adafruit/Adafruit-24LC32-PCB/Adafruit 24LC32 I2C EEPROM.brd

## EAGLE design Adafruit 24LC32 I2C EEPROM.brd (2021-08-11)

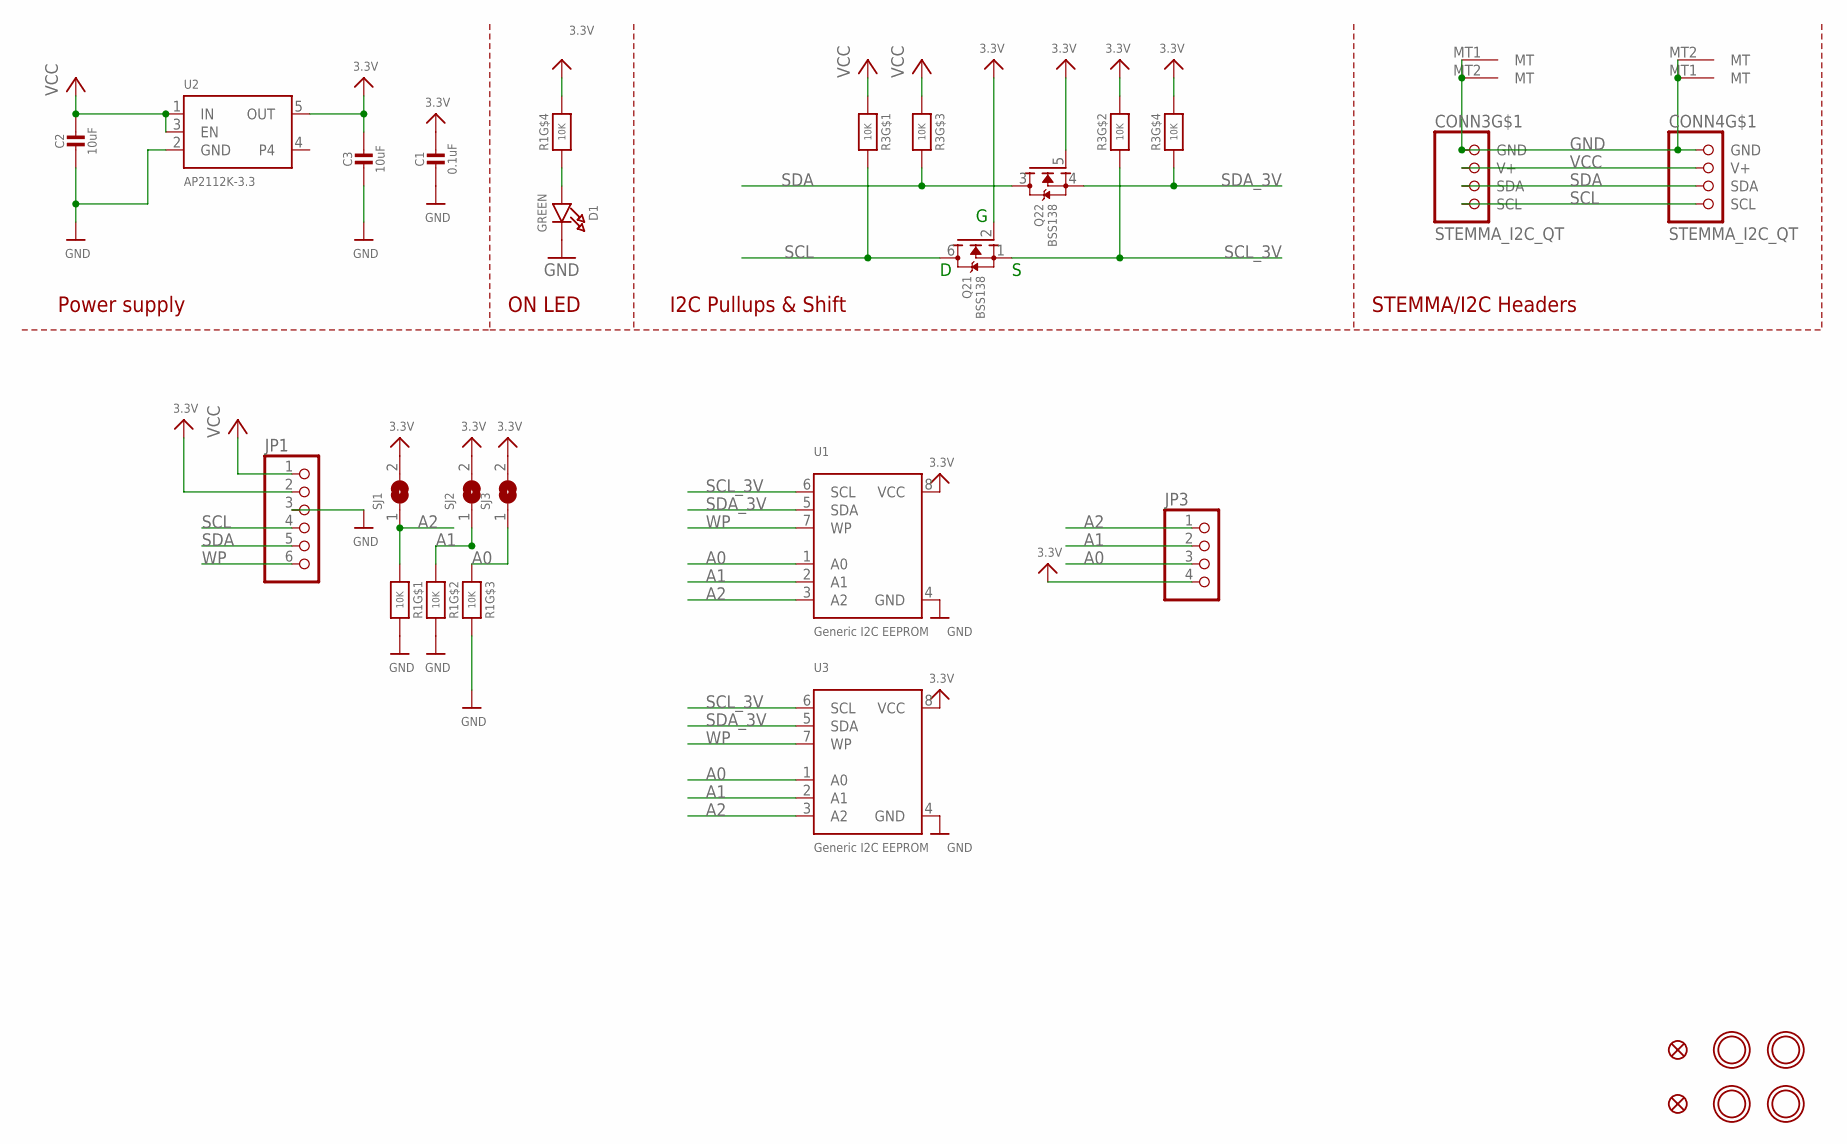
[picture p2: schematic Adafruit 24LC32 I2C EEPROM.sch]

Parts:
C1: 0.1uF; 0603-NO
C2, C3: 10uF; 0805-NO
CONN3, CONN4: STEMMA_I2C_QT; JST_SH4
D1: GREEN; CHIPLED_0603_NOOUTLINE
FID3, FID4: FIDUCIAL_1MM
JP1: HEADER-1X670MIL; 1X06_ROUND_70
JP3: HEADER-1X4ROUND; 1X04_ROUND
Q2: BSS138; SOT363
R1, R3: 10K; RESPACK_4X0603
SJ1, SJ2, SJ3: SOLDERJUMPER; SOLDERJUMPER_ARROW_NOPASTE
U1: Generic I2C EEPROM; SOIC8_150MIL
U2: AP2112K-3.3; SOT23-5
U3: Generic I2C EEPROM; USON8
U$1, U$17, U$19, U$21: MOUNTINGHOLE2.5; MOUNTINGHOLE_2.5_PLATED

Connections:
3.3V: C1.1, C3.1, JP1.2, JP3.4, Q2.2 (G), Q2.5 (G), R1.5 (2), R3.2 (1), R3.4 (1), SJ1.2, SJ2.2, SJ3.2, U1.8 (VCC), U2.5 (OUT), U3.8 (VCC)
A0: JP3.3, R1.3 (1), SJ3.1, U1.1 (A0), U3.1 (A0)
A1: JP3.2, R1.2 (1), SJ2.1, U1.2 (A1), U3.2 (A1)
A2: JP3.1, R1.1, SJ1.1, U1.3 (A2), U3.3 (A2)
GND: C1.2, C2.2, C3.2, CONN3.1 (GND), CONN3.MT1 (MT), CONN3.MT2 (MT), CONN4.1 (GND), CONN4.MT1 (MT), CONN4.MT2 (MT), D1.C, JP1.3, R1.6 (2), R1.7 (2), R1.8 (2), U1.4 (GND), U2.2 (GND), U3.4 (GND)
unnamed: D1.A, R1.4 (1)
SCL: CONN3.4 (SCL), CONN4.4 (SCL), JP1.4, Q2.6 (D), R3.8 (2)
SCL_3V: Q2.1 (S), R3.7 (2), U1.6 (SCL), U3.6 (SCL)
SDA: CONN3.3 (SDA), CONN4.3 (SDA), JP1.5, Q2.3 (D), R3.6 (2)
SDA_3V: Q2.4 (S), R3.5 (2), U1.5 (SDA), U3.5 (SDA)
VCC: C2.1, CONN3.2 (V+), CONN4.2 (V+), JP1.1, R3.1, R3.3 (1), U2.1 (IN), U2.3 (EN)
WP: JP1.6, U1.7 (WP), U3.7 (WP)

Notes on the sheet:
I2C Pullups & Shift
STEMMA/I2C Headers
ON LED
Power supply

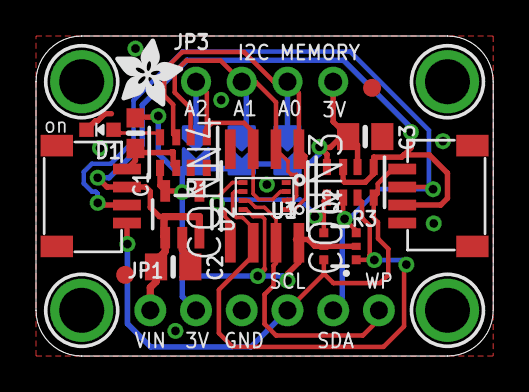
[picture p3: board Adafruit 24LC32 I2C EEPROM.brd from above]

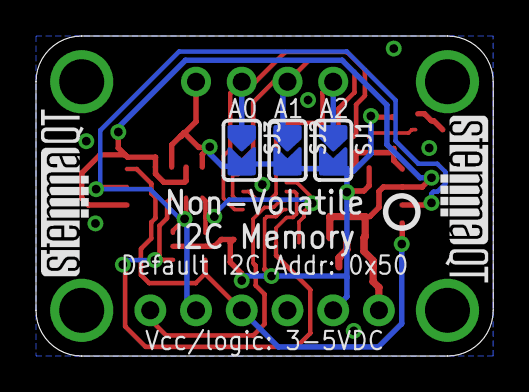
[picture p4: board Adafruit 24LC32 I2C EEPROM.brd from below]

Board: 2 copper layers, 25.4 x 17.8 mm, 27 parts (6 on the bottom side), 12 nets.

Other parts of the board:
U$25: PCBFEAT-REV-040
U$30, U$31: STEMMAQT
U$32: ADAFRUIT_3.5MM
